MakeMagazinDE/Zisternensensor/README.md

GitHub Logo

Maker Media GmbH

***

# Blutdruckmessung an einer Regenwasserzisterne

### In diesem Artikel aus Make 6/21 zeigen wir  Ihnen die Füllstandmessung einer Regenwasserzisterne einmal ganz anders. Es kommt ein ausrangierter elektronischer Blutdruckmesser zum Einsatz.

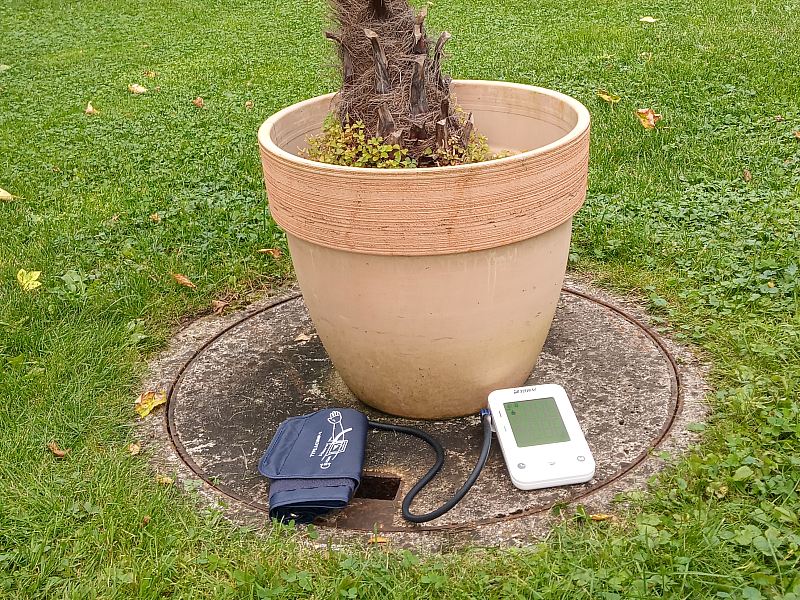
[picture p1: Sensor.jpg]
 

Hier finden Sie den Arduino Code.

Den vollständigen Artikel mit der Bauanleitung gibt es in der [Make-Ausgabe 6/21 ab Seite 74](https://www.heise.de/select/make/2021/6/2125307172628359231).
